zigaPerne/magistrska/skatla/Assem2.SLDASM

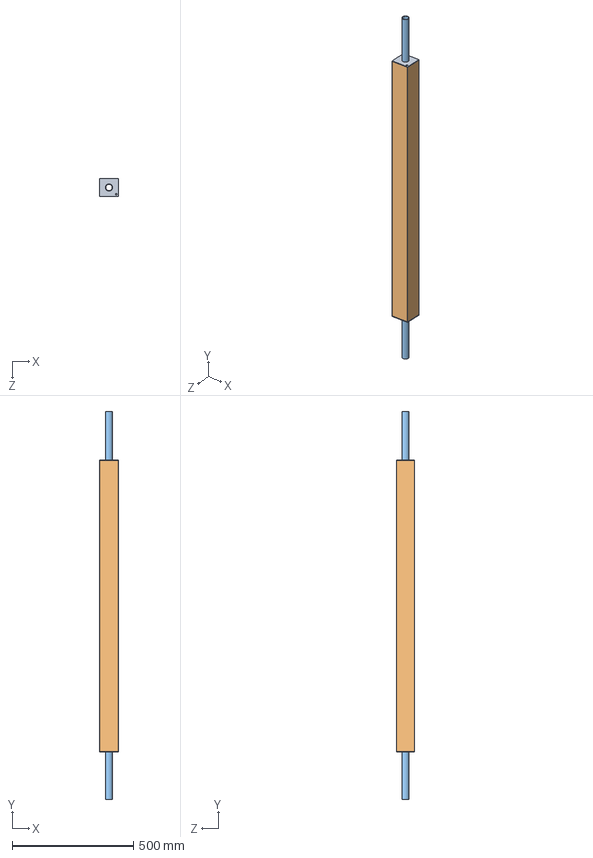
[picture p11: CAD file, 2023-08-13]
skatla/Assem2.SLDASM
80.0 x 1600.0 x 75.0 mm
