zigaPerne/magistrska/skatla/Part1.SLDPRT

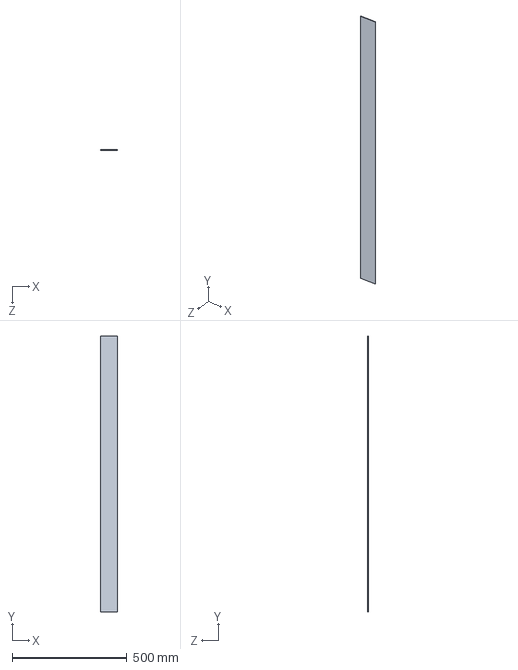
[picture p12: CAD file, 2023-08-13]
skatla/Part1.SLDPRT
75.0 x 1200.0 x 2.50 mm
