zigaPerne/magistrska/skatla/Part2.SLDPRT

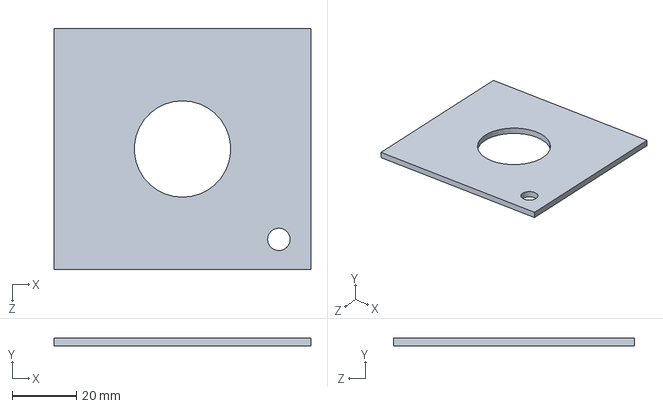
[picture p13: CAD file, 2023-08-13]
skatla/Part2.SLDPRT
80.0 x 2.50 x 75.0 mm
