zigaPerne/magistrska/skatla/Part3.SLDPRT

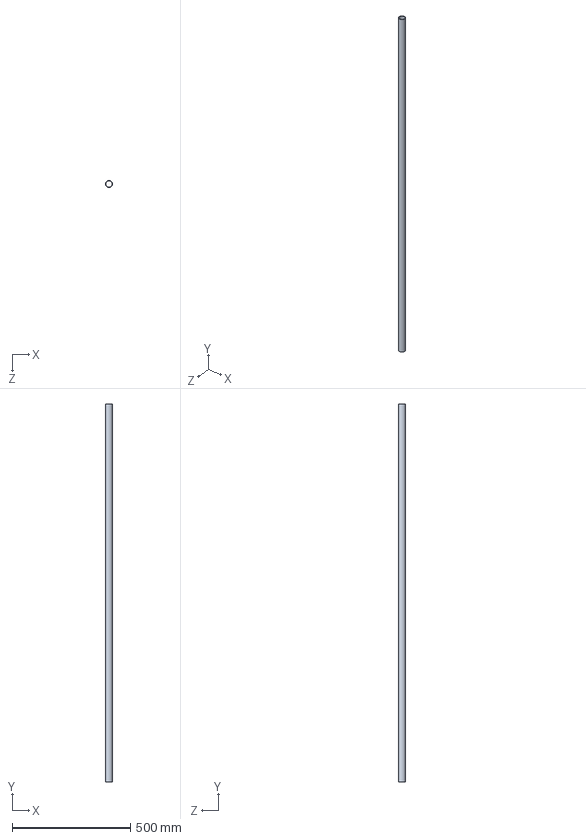
[picture p14: CAD file, 2023-08-13]
skatla/Part3.SLDPRT
30.0 x 1600.0 x 30.0 mm
