zigaPerne/magistrska/(list of files, cad)

Other CAD files:
skatla/Assem2.SLDDRW
